F1CJN/Arduino-AD8302-OLED-RF-Power-meter-or-field-strengh-meter/snapshot.jpg

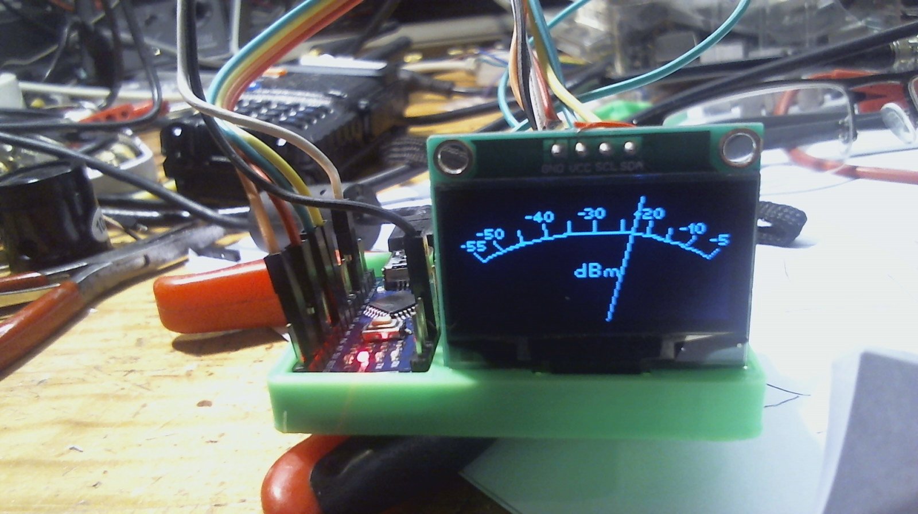
snapshot.jpg
