F1CJN/Arduino-AD8302-OLED-RF-Power-meter-or-field-strengh-meter/boîtier.JPG

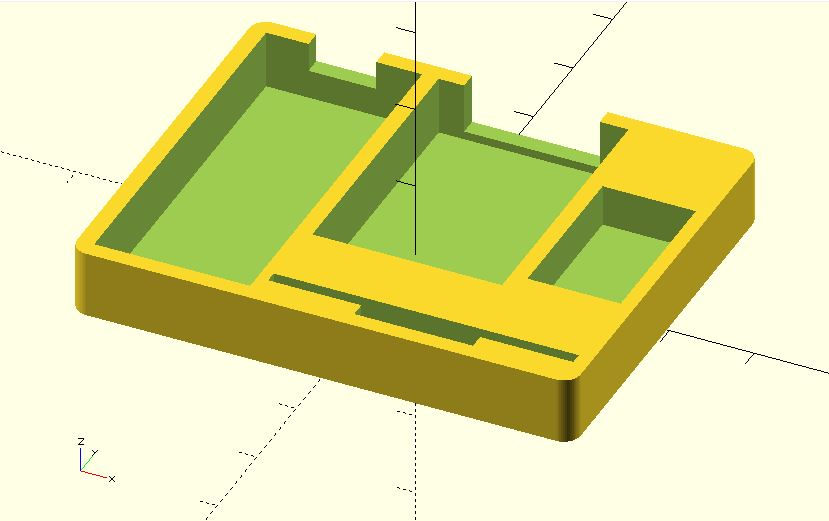
boîtier.JPG
