F1CJN/Arduino-AD8302-OLED-RF-Power-meter-or-field-strengh-meter/Arduino_RF_Power_Meter.stl

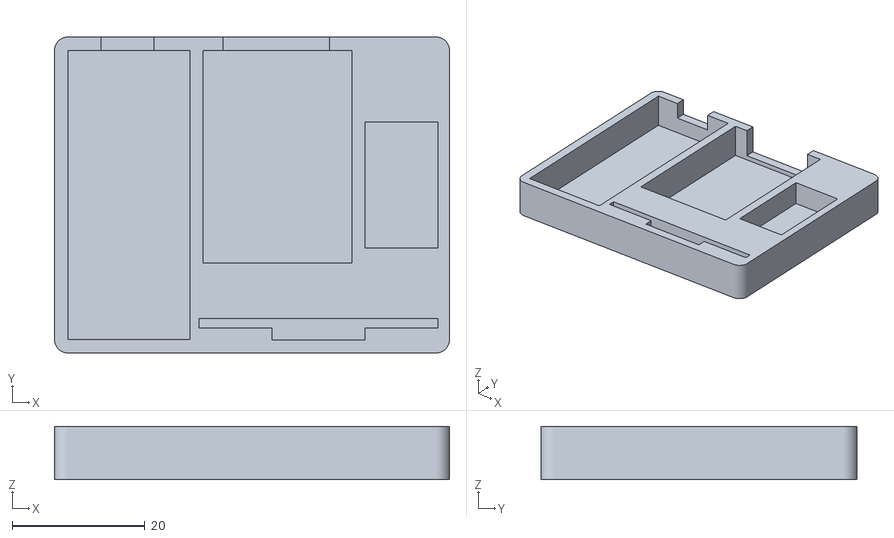
[picture p5: CAD file, 2018-12-07]
Arduino_RF_Power_Meter.stl
59.4 x 47.5 x 8.00
