F1CJN/Arduino-AD8302-OLED-RF-Power-meter-or-field-strengh-meter/OLED_Meter_dB.ino

/*   Program written by Alain Fort  Hamradio F1CJN December 2018
 *    
 *   OLEDmeter is written to use a 128x64 1.3" OLED display I2C SH1106. 
 *  
 *  Remaining code was written by Greg Stievenart with no claim to or any images or information 
 *  provided in this code. Freely published May 26, 2016.
 *  
 *  Software to convert background BMP 128x64 image to hex code at: http://www.ablab.in/image2glcd-software/
 *  
 */

#include <Wire.h>                     // requried to run I2C SH1106
#include <SPI.h>                      // requried to run I2C SH1106
#include <Adafruit_GFX.h>             // https://github.com/adafruit/Adafruit-GFX-Library
#include <Adafruit_SH1106.h>          // https://github.com/wonho-maker/Adafruit_SH1106

#define OLED_RESET 4                  // reset required for SH1106
Adafruit_SH1106 display(OLED_RESET);  // reset required for SH1106

int hMeter = 65;                      // horizontal center for needle animation
int vMeter = 85;                      // vertical center for needle animation (outside of dislay limits)
int rMeter = 100;                     // length of needle animation or arch of needle travel
unsigned int sample;

// VU meter background mask image:
static const unsigned char PROGMEM VUMeterdB[] = { 
0x00, 0x00, 0x00, 0x00, 0x00, 0x00, 0x00, 0x00, 0x00, 0x00, 0x00, 0x00, 0x00, 0x00, 0x00, 0x00, 
0x00, 0x00, 0x00, 0x00, 0x00, 0x00, 0x00, 0x00, 0x00, 0x00, 0x00, 0x00, 0x00, 0x00, 0x00, 0x00, 
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
  display.begin(SH1106_SWITCHCAPVCC,0x3C);                 // needed for SH1106 display
  display.clearDisplay();                                  // clears display
  Serial.begin(115200);                                    // for test
}

void loop(){
  unsigned long Peak;                            //
  float VMAG;
  float dB;
  
  sample = analogRead(A0);  // Read analog VMAG level with A0 input
  sample = sample * 3; // pour avoir 100% de deviation = environ 1023 avec AD8302
  Serial.println(sample);
  float MeterValue = (sample * 90) / 1024;   // convertit lecture volts en lecture degrés
  //Serial.println(MeterValue);
  
  MeterValue = MeterValue - 45;                       // shifts -45° needle for zero position
  Serial.println(MeterValue);
  if (MeterValue > 45) MeterValue=45;  // Butée pour ne pas tordre l'aguille !!!! 
  if (MeterValue < -45) MeterValue=-45; // 
  display.clearDisplay();                                  // clear display
  display.drawBitmap(0, 0, VUMeterdB, 128, 64, WHITE);       // draws background scale in dB
  int a1 = (hMeter + (sin(MeterValue / 57.296) * rMeter)); // meter needle horizontal coordinate
  int a2 = (vMeter - (cos(MeterValue / 57.296) * rMeter)); // meter needle vertical coordinate
  display.drawLine(a1, a2, hMeter, vMeter, WHITE);         // draws needle
  display.display();
  delay (100);
}
